HectorJardines/micromouse/README.md

# micromouse
IEEE MicroMouse competition mouse
