HectorJardines/micromouse/bare_mouse/bloo.kicad_pcb

## KiCad design bare_mouse/bloo.kicad_pcb (2025-11-26, last stored version)

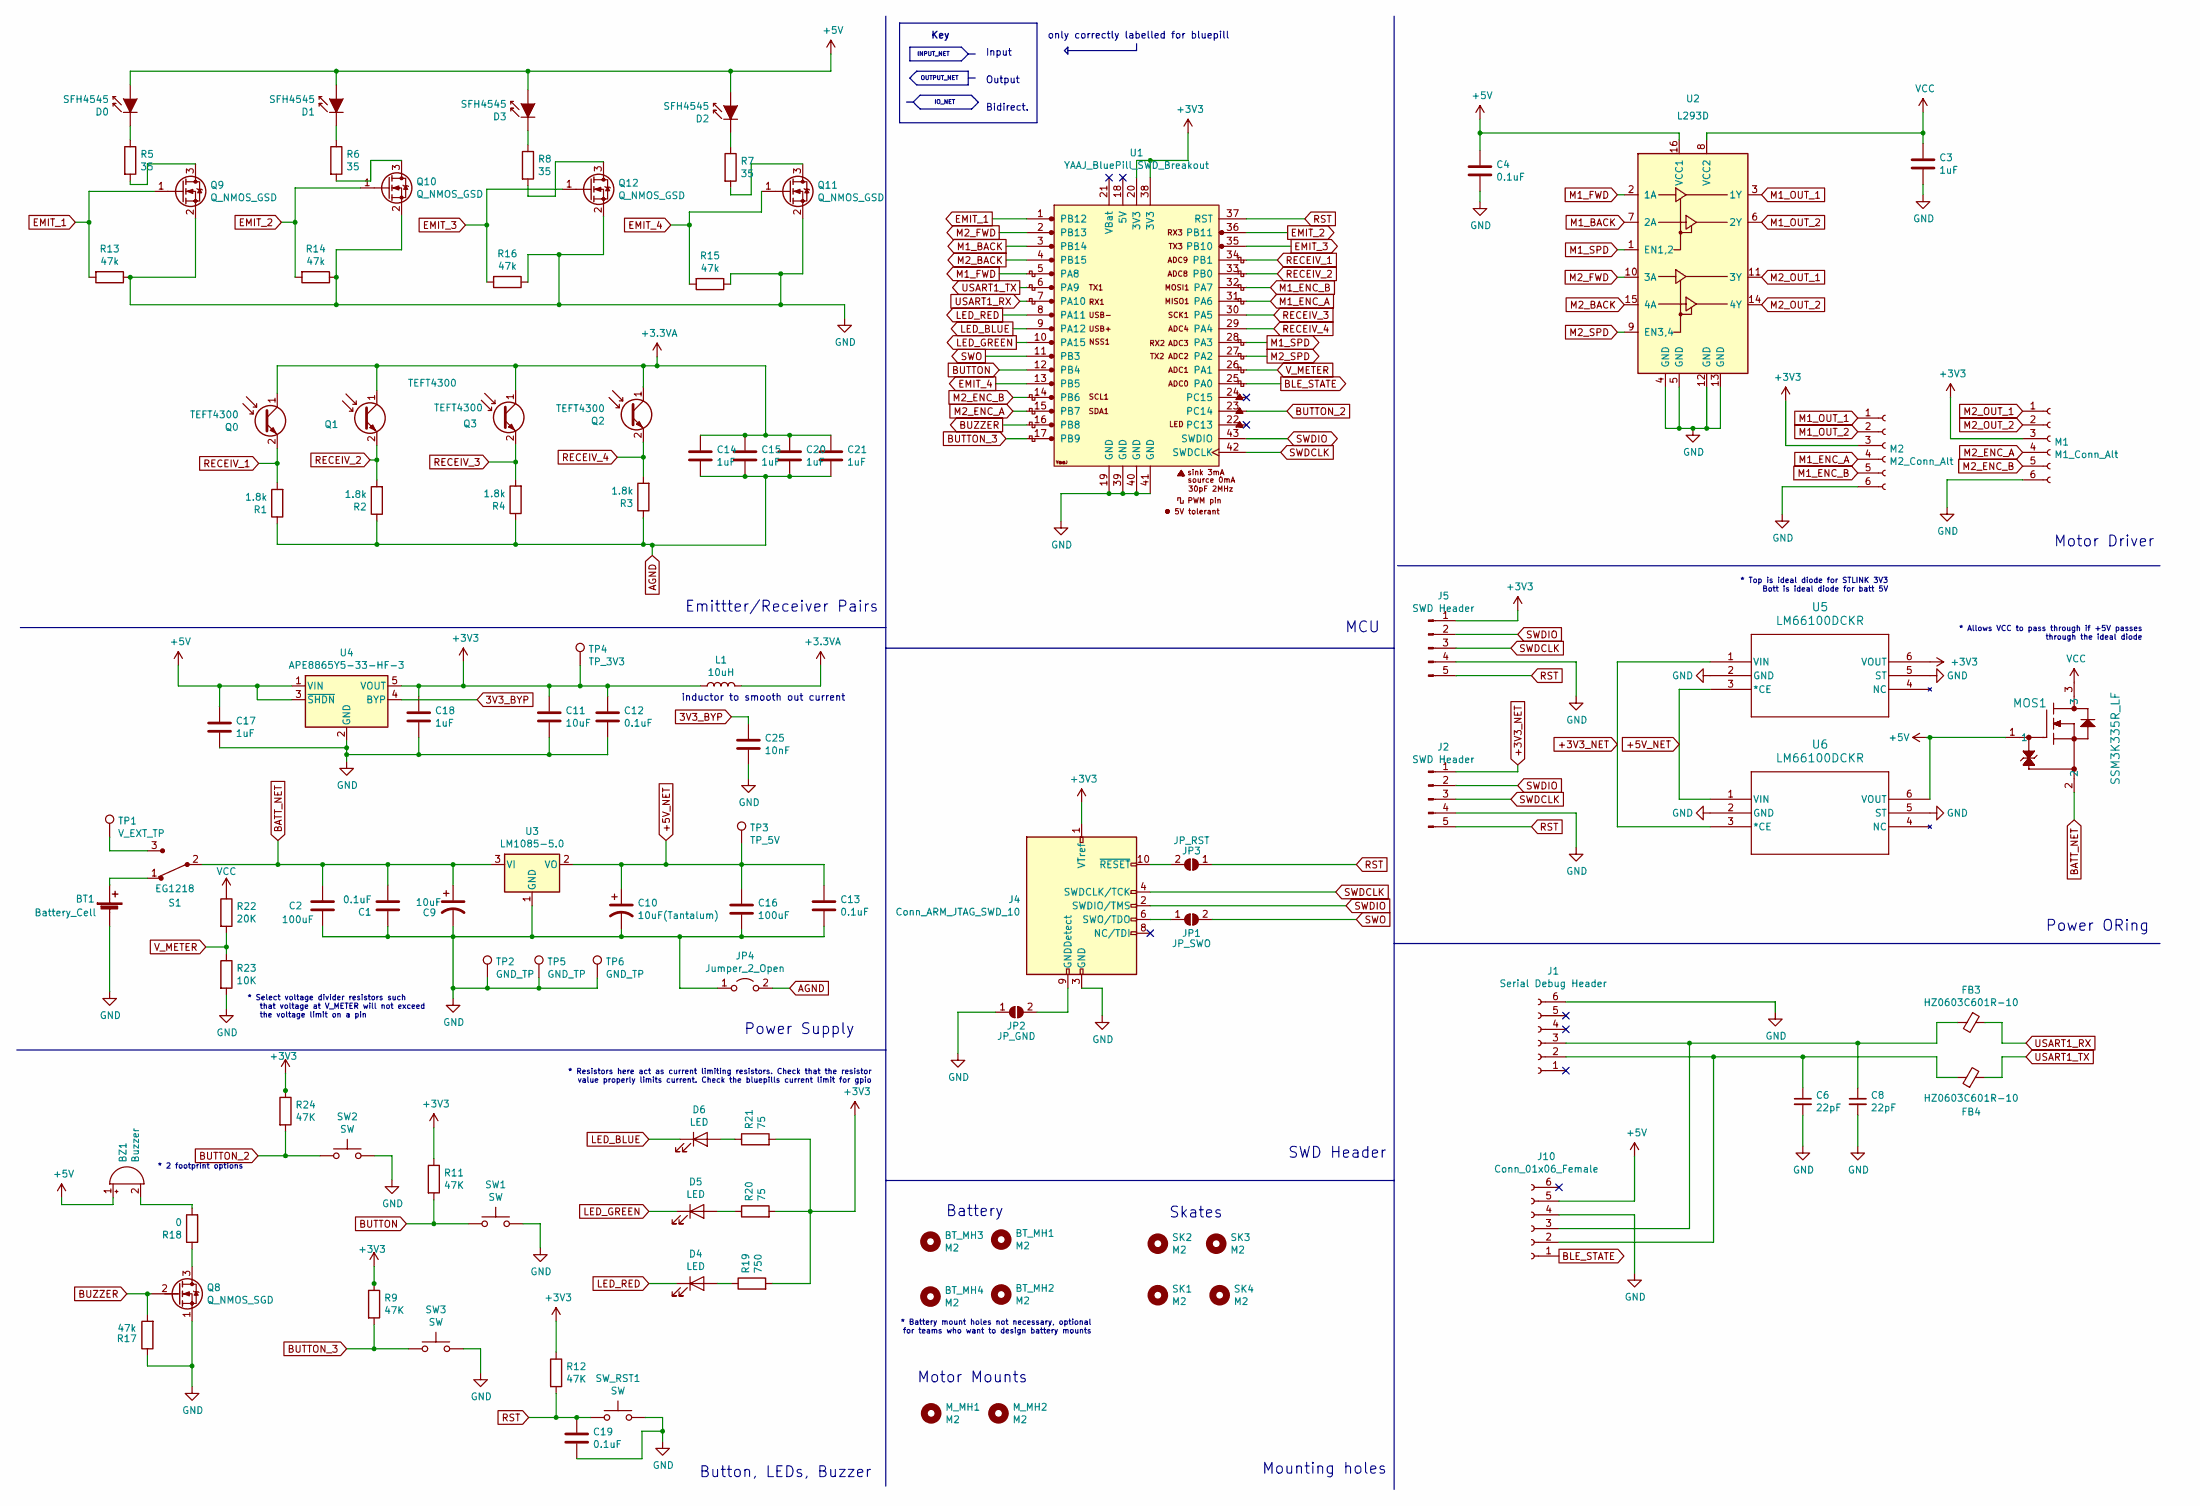
[picture p1: schematic bloo.kicad_sch]

Parts:
BT1: Battery_Cell; PinSocket_1x02_P2.54mm_Vertical
BT_MH1, BT_MH2, BT_MH3, BT_MH4: M2; MountingHole_2.2mm_M2
BZ1: Buzzer; MagneticBuzzer_PUI_AT-0927-TT-6-R
C1, C4, C12, C13, C19: 0.1uF; C_1206_3216Metric_Pad1.33x1.80mm_HandSolder
C2, C16: 100uF; CP_Radial_D6.3mm_P2.50mm
C3, C14, C15, C17, C18, C20, C21: 1uF; C_1206_3216Metric_Pad1.33x1.80mm_HandSolder
C6, C8: 22pF; C_0603_1608Metric_Pad1.08x0.95mm_HandSolder
C9, C11: 10uF; C_1206_3216Metric_Pad1.33x1.80mm_HandSolder
C10: 10uF(Tantalum); C_1206_3216Metric_Pad1.33x1.80mm_HandSolder
C25: 10nF; C_1206_3216Metric_Pad1.33x1.80mm_HandSolder
D0, D1, D2, D3: SFH4545; Emitter
D4, D5, D6: LED; LED_0805_2012Metric_Pad1.15x1.40mm_HandSolder
FB3, FB4: HZ0603C601R-10; R_0603_1608Metric_Pad0.98x0.95mm_HandSolder
J1: Serial Debug Header; PinHeader_1x06_P2.54mm_Vertical
J2, J5: SWD Header; PinHeader_1x05_P2.54mm_Vertical
J4: Conn_ARM_JTAG_SWD_10; PinHeader_2x05_P1.27mm_Vertical
J10: Conn_01x06_Female; PinSocket_1x06_P2.54mm_Vertical
JP1: JP_SWO; SolderJumper-2_P1.3mm_Open_Pad1.0x1.5mm
JP2: JP_GND; SolderJumper-2_P1.3mm_Open_Pad1.0x1.5mm
JP3: JP_RST; SolderJumper-2_P1.3mm_Open_Pad1.0x1.5mm
JP4: Jumper_2_Open; SolderJumper-2_P1.3mm_Bridged_Pad1.0x1.5mm
L1: 10uH; L_1206_3216Metric_Pad1.42x1.75mm_HandSolder
M1: M1_Conn_Alt; Motor Headers
M2: M2_Conn_Alt; Motor Headers
MOS1: SSM3K335R_LF; SOT-23F_TOS
M_MH1, M_MH2: M2; Motor_mouse
Q0, Q1, Q2, Q3: TEFT4300; Emitter
Q8: Q_NMOS_SGD; SOT-23
Q9, Q10, Q11, Q12: Q_NMOS_GSD; SOT-23
R1, R2, R3, R4: 1.8k; R_1206_3216Metric_Pad1.30x1.75mm_HandSolder
R5, R6, R7, R8: 35; R_1206_3216Metric_Pad1.30x1.75mm_HandSolder
R9, R11, R12, R24: 47K; R_1206_3216Metric_Pad1.30x1.75mm_HandSolder
R13, R14, R15, R16, R17: 47k; R_1206_3216Metric_Pad1.30x1.75mm_HandSolder
R18: 0; R_1206_3216Metric_Pad1.30x1.75mm_HandSolder
R19: 750; R_1206_3216Metric_Pad1.30x1.75mm_HandSolder
R20, R21: 75; R_1206_3216Metric_Pad1.30x1.75mm_HandSolder
R22: 20K; R_1206_3216Metric_Pad1.30x1.75mm_HandSolder
R23: 10K; R_1206_3216Metric_Pad1.30x1.75mm_HandSolder
S1: EG1218; MM Switch; MPN EG1218; Digi-Key_PN EG1903-ND
SK1, SK2, SK3, SK4: M2; MountingHole_2.2mm_M2
SW1, SW2, SW3: SW; SW_SPST_REED_CT05-XXXX-G1
SW_RST1: SW; SW_SPST_REED_CT05-XXXX-G1
TP1: V_EXT_TP; PinHeader_1x01_P2.54mm_Vertical
TP2, TP5, TP6: GND_TP; PinHeader_1x01_P2.54mm_Vertical
TP3: TP_5V; PinHeader_1x01_P2.54mm_Vertical
TP4: TP_3V3; PinHeader_1x01_P2.54mm_Vertical
U1: YAAJ_BluePill_SWD_Breakout; STM32F103
U2: L293D; DIP-16_W7.62mm
U3: LM1085-5.0; 5V Voltage Reg
U4: APE8865Y5-33-HF-3; SOT-23-5
U5, U6: LM66100DCKR; DCK6_TEX

Connections:
3V3_BYP: C25.1, U4.4 (BYP)
+3.3VA: C14.1, C15.1, C20.1, C21.1, L1.2, Q0.1 (C), Q1.1 (C), Q2.1 (C), Q3.1 (C)
+3V3: C11.1, C12.1, C18.1, J4.1 (VTref), J5.1, L1.1, M1.3, M2.3, R9.1, R11.1, R12.1, R19.2, R20.2, R21.2, R24.1, TP4.1, U1.20 (3V3), U1.38 (3V3), U4.5 (VOUT), U5.6 (VOUT)
+3V3_NET: J2.1, U5.1 (VIN), U6.3 (*CE)
+5V: BZ1.1 (-), C4.1, C17.1, D0.2 (A), D1.2 (A), D2.2 (A), D3.2 (A), J10.5, MOS1.1, U2.16 (VCC1), U4.1 (VIN), U4.3 (~SHDN), U6.6 (VOUT)
+5V_NET: C10.1, C13.1, C16.1, TP3.1, U3.2 (VO), U5.3 (*CE), U6.1 (VIN)
AGND: C14.2, C15.2, C20.2, C21.2, JP4.2 (B), R1.1, R2.1, R3.1, R4.1
BATT_NET: C1.2, C2.1, C9.1, MOS1.2, S1.2, U3.3 (VI)
BLE_STATE: J10.1, U1.25 (PA0)
BUTTON: R11.2, SW1.1, U1.12 (PB4)
BUTTON_2: R24.2, SW2.1, U1.23 (PC14)
BUTTON_3: R9.2, SW3.1, U1.17 (PB9)
BUZZER: Q8.2 (G), R17.2, U1.16 (PB8)
EMIT_1: Q9.1 (G), R13.2, U1.1 (PB12)
EMIT_2: Q10.1 (G), R14.2, U1.36 (PB11)
EMIT_3: Q12.1 (G), R16.2, U1.35 (PB10)
EMIT_4: Q11.1 (G), R15.2, U1.13 (PB5)
GND: BT1.2 (-), C1.1, C2.2, C3.2, C4.2, C6.2, C8.2, C9.2, C10.2, C11.2, C12.2, C13.2, C16.2, C17.2, C18.2, C19.2, C25.2, J1.6, J2.4, J4.3 (GND), J4.5 (GND), J5.4, J10.4, JP2.1 (A), JP4.1 (A), M1.6, M2.6, Q8.1 (S), Q9.2 (S), Q10.2 (S), Q11.2 (S), Q12.2 (S), R13.1, R14.1, R15.1, R16.1, R17.1, R23.2, SW1.2, SW2.2, SW3.2, SW_RST1.2, TP2.1, TP5.1, TP6.1, U1.19 (GND), U1.39 (GND), U1.40 (GND), U1.41 (GND), U2.4 (GND), U2.5 (GND), U2.12 (GND), U2.13 (GND), U3.1 (GND), U4.2 (GND), U5.2 (GND), U5.5 (ST), U6.2 (GND), U6.5 (ST)
LED_BLUE: D6.1 (K), U1.9 (PA12)
LED_GREEN: D5.1 (K), U1.10 (PA15)
LED_RED: D4.1 (K), U1.8 (PA11)
M1_BACK: U1.3 (PB14), U2.7 (2A)
M1_ENC_A: M2.4, U1.31 (PA6)
M1_ENC_B: M2.5, U1.32 (PA7)
M1_FWD: U1.5 (PA8), U2.2 (1A)
M1_OUT_1: M2.1, U2.3 (1Y)
M1_OUT_2: M2.2, U2.6 (2Y)
M1_SPD: U1.28 (PA3), U2.1 (EN1,2)
M2_BACK: U1.4 (PB15), U2.15 (4A)
M2_ENC_A: M1.4, U1.15 (PB7)
M2_ENC_B: M1.5, U1.14 (PB6)
M2_FWD: U1.2 (PB13), U2.10 (3A)
M2_OUT_1: M1.1, U2.11 (3Y)
M2_OUT_2: M1.2, U2.14 (4Y)
M2_SPD: U1.27 (PA2), U2.9 (EN3,4)
unnamed: BT1.1 (+), S1.1
unnamed: BZ1.2 (+), R18.2
unnamed: D0.1 (K), R5.1
unnamed: D1.1 (K), R6.1
unnamed: D2.1 (K), R7.1
unnamed: D3.1 (K), R8.1
unnamed: D4.2 (A), R19.1
unnamed: D5.2 (A), R20.1
unnamed: D6.2 (A), R21.1
unnamed: C6.1, FB4.1, J1.2, J10.2
unnamed: C8.1, FB3.2, J1.3, J10.3
unnamed: J4.9 (GNDDetect), JP2.2 (B)
unnamed: J4.6 (SWO/TDO), JP1.1 (A)
unnamed: J4.10 (~RESET), JP3.2 (B)
unnamed: Q8.3 (D), R18.1
unnamed: Q9.3 (D), R5.2
unnamed: Q10.3 (D), R6.2
unnamed: Q11.3 (D), R7.2
unnamed: Q12.3 (D), R8.2
unnamed: S1.3, TP1.1
RECEIV_1: Q0.2 (E), R1.2, U1.34 (PB1)
RECEIV_2: Q1.2 (E), R2.2, U1.33 (PB0)
RECEIV_3: Q3.2 (E), R4.2, U1.30 (PA5)
RECEIV_4: Q2.2 (E), R3.2, U1.29 (PA4)
RST: C19.1, J2.5, J5.5, JP3.1 (A), R12.2, SW_RST1.1, U1.37 (RST)
SWDCLK: J2.3, J4.4 (SWDCLK/TCK), J5.3, U1.42 (SWDCLK)
SWDIO: J2.2, J4.2 (SWDIO/TMS), J5.2, U1.43 (SWDIO)
SWO: JP1.2 (B), U1.11 (PB3)
USART1_RX: FB3.1, U1.7 (PA10)
USART1_TX: FB4.2, U1.6 (PA9)
VCC: C3.1, MOS1.3, R22.1, U2.8 (VCC2)
V_METER: R22.2, R23.1, U1.26 (PA1)

Notes on the sheet:
Mounting holes
Output
IO_NET
Power ORing
Battery
Input
inductor to smooth out current
* 2 footprint options
* Battery mount holes not necessary, optional for teams who want to design battery mounts
* Top is ideal diode for STLINK 3V3 Bott is ideal diode for batt 5V
Motor Driver
* Allows VCC to pass through if +5V passes through the ideal diode
Emittter/Receiver Pairs
* Resistors here act as current limiting resistors. Check that the resistor value properly limits current. Check the bluepills current limit for gpio
Bidirect.
MCU
OUTPUT_NET
SWD Header
only correctly labelled for bluepill
* Select voltage divider resistors such that voltage at V_METER will not exceed the voltage limit on a pin
Motor Mounts
Button, LEDs, Buzzer
Skates
Power Supply
Key
INPUT_NET

Board: 2 copper layers, 103 parts (0 on the bottom side), 67 nets, no tracks yet.
