HectorJardines/micromouse/Core/Inc/drivers/io.h

#ifndef _IO_H
#define _IO_H

#include "../../Drivers/STM32F1xx_HAL_Driver/Inc/stm32f1xx_hal.h"
#include <stdint.h>
#include <stdbool.h>

#define ENABLE  (0x1U)
#define DISABLE (0x0U)
#define SET     (ENABLE)
#define RESET   (DISABLE)

/**********************************
*          USER IO ENUMS
***********************************/
typedef enum 
{
    IO_PORTA_NUM,
    IO_PORTB_NUM,
    IO_PORTC_NUM
} io_port_num_e;

typedef enum
{
    IO_PIN_0,
    IO_PIN_1,
    IO_PIN_2,
    IO_PIN_3,
    IO_PIN_4,
    IO_PIN_5,
    IO_PIN_6,
    IO_PIN_7,
    IO_PIN_8,
    IO_PIN_9,
    IO_PIN_10,
    IO_PIN_11,
    IO_PIN_12,
    IO_PIN_13,
    IO_PIN_14,
    IO_PIN_15
} io_pin_no_e;

typedef enum
{
    // PORT A
    IO_A0, IO_A1, IO_A2, IO_A3,
    IO_A4, IO_A5, IO_A6, IO_A7,
    IO_A8, IO_A9, IO_A10, IO_A11,
    IO_A12, IO_A13, IO_A14, IO_A15,

    // PORT B
    IO_B0, IO_B1, IO_B2, IO_B3,
    IO_B4, IO_B5, IO_B6, IO_B7,
    IO_B8, IO_B9, IO_B10, IO_B11,
    IO_B12, IO_B13, IO_B14, IO_B15,

    // PORT C
    IO_C0, IO_C1, IO_C2, IO_C3,
    IO_C4, IO_C5, IO_C6, IO_C7,
    IO_C8, IO_C9, IO_C10, IO_C11,
    IO_C12, IO_C13, IO_C14, IO_C15
} generic_io_e;

typedef enum
{
    // PORT A PINS
    IO_UNUSED_0 = IO_A0,
    BMI160_INT_CH1 = IO_A1,
    IO_M1_PWM = IO_A2,
    IO_M2_PWM = IO_A3,
    IO_IR_RECEIVE_4 = IO_A4,
    IO_IR_RECEIVE_3 = IO_A5,
    M1_ENC_A = IO_A6,
    M1_ENC_B = IO_A7,
    M1_DRIVER_IN1 = IO_A8,

    // TODO: VERIFY THAT WE WONT NEED THESE FOR I2C/SPI COMMS
    IO_IR_EMIT_4 = IO_A9,
    IO_IR_EMIT_3 = IO_A10,
    IO_IR_EMIT_2 = IO_A11,
    IO_IR_EMIT_1 = IO_A12,

    IO_RESERVED_13 = IO_A13,
    IO_RESERVED_14 = IO_A14,
    IO_UNUSED_15 = IO_A15,

    // PORT B PINS
    IO_IR_RECEIVE_2 = IO_B0,
    IO_IR_RECEIVE_1 = IO_B1,
    M2_DRIVER_IN1 = IO_B2, // USE FOR M2_DRIVER_IN1
    IO_UNUSED_19 = IO_B3,
    M1_DRIVER_IN2 = IO_B4, // USE FOR M1_DRIVER_IN2
    M2_DRIVER_IN2 = IO_B5,
    I2C1_SCL = IO_B6, // REMAP TO B8, use this for I2C1_SCL
    I2C1_SDA = IO_B7, // REMAP TO B9, use this for I2C1_SDA

    M2_ENC_B = IO_B8, // USE FOR TIM4_CH3
    M2_ENC_A = IO_B9, // USE FOR TIM4_CH4
    IO_USART3_TX = IO_B10,
    IO_USART3_RX = IO_B11,
    SPI2_NSS = IO_B12,
    SPI2_SCK = IO_B13,
    SPI2_MISO = IO_B14,
    SPI2_MOSI = IO_B15,

    // PORT C PINS
    IO_RESERVED_32 = IO_C0,
    IO_RESERVED_33 = IO_C1,
    IO_RESERVED_34 = IO_C2,
    IO_RESERVED_35 = IO_C3,
    IO_RESERVED_36 = IO_C4,
    IO_RESERVED_37 = IO_C5,
    IO_RESERVED_38 = IO_C6,
    IO_RESERVED_39 = IO_C7,
    IO_RESERVED_40 = IO_C8,
    IO_RESERVED_41 = IO_C9,
    IO_RESERVED_42 = IO_C10,
    IO_RESERVED_43 = IO_C11,
    IO_RESERVED_44 = IO_C12,
    IO_LED_RED = IO_C13,
    IO_LED_BLUE = IO_C14,
    IO_LED_GREEN = IO_C15
} io_e;

typedef enum
{
    io_mode_input,
    io_mode_output_10MHz,
    io_mode_output_2MHz,
    io_mode_output_50MHz,
    io_mode_reserved
} io_mode_e;

typedef enum
{
    io_cnf_input_analog,
    io_cnf_input_float,
    io_cnf_input_pupd
} io_cnf_input_e;

typedef enum
{
    io_cnf_output_gpio_pp,
    io_cnf_output_gpio_od,
    io_cnf_output_af_pp,
    io_cnf_output_af_od,
    io_cnf_reserved
} io_cnf_output_e;

typedef enum
{
    exti_no_0,
    exti_no_1,
    exti_no_2,
    exti_no_3,
    exti_no_4,
    exti_no_5,
    exit_no_6,
    exti_no_7,
    exti_no_8,
    exit_no_9,
    exti_no_10,
    exti_no_11,
    exit_no_12,
    exti_no_13,
    exti_no_14,
    exti_no_15
} exti_no_e;

typedef enum
{
    io_it_ft,
    io_it_rt,
    io_it_ft_rt
} io_it_trigger_e;

typedef enum 
{
    LOW,
    HIGH
} io_out_e;

/**********************************
*          USER IO Structs
***********************************/
typedef struct
{
    uint8_t mode;           /* Specifies Mode: Input (default) OR Output [10/2/50MHz] */
    uint8_t mode_config;    /* Specifies Mode Config: Input (analog, floating input, push-pull) OR Output (GPIO PP/OD : AF PP/OD) */

} io_config_t;

/**********************************
*          USER IO APIs
***********************************/
/**
 * @brief sets the output for the specified io pin
 */
void io_set_out(io_e io, io_out_e out);

/**
 * @brief toggles the output for the speecified io pin
 */
void io_toggle_out(io_e io);

/**
*   io_configure - Sets the configuration of all the pins used/unused
*   
*
*   @return void
**/
void io_configure(void);

/**
*   io_init - inits a singles io pin with the specified configuration struct
*   
*   @param io_config - io pin configuration struct, specifies mode/speed, resistance, etc.
*   @return void
**/
void io_init(io_e io, const io_config_t *io_config);

/**
 *  io_get_configuration -  retrieves the actual configuration of the initialized
 *                          pin and stores the configuration into a struct
 * 
 *  @param io - io pin to retrieve configuration of
 *  @return io_config_t
 */
void io_get_configuration(io_e io, io_config_t *actual);

/**
 *  io_verify_config -  compares configured io pin with config struct
 * 
 *  @param curr_cnf - io pin to check configuration of
 *  @param expected_cnf - expected io configuration
 *  @return void
 */
bool io_verify_config(io_config_t *curr_cnf, io_config_t *expected_cnf);


void io_set_out(io_e, io_out_e);

#endif
