HectorJardines/micromouse/Core/tests/test_hardware.c

#include "../inc/common/assert_handler.h"
#include "../inc/drivers/io.h"
#include "../inc/drivers/uart.h"
#include "../inc/main.h"
#include "../external/printf/printf.h"
#include "../Inc/drivers/encoder.h"
#include "../Inc/common/log.h"
#include "../Inc/drivers/pid.h"
#include "../Inc/drivers/pwm.h"
#include "../Inc/drivers/imu_interface.h"
#include "../Inc/drivers/ssd1306.h"
#include "../Inc/drivers/ir_interface.h"

void test_setup(void) {
    SystemClock_Config();
    // HAL_MspInit();
    io_configure();
    log_init();
    log_set_level(LOG_LEVEL_DEBUG);
}

void test_uart(void) {
    usart_init();
    char msg[7] = "Hello\n";
    while(1) {
        usart_write(msg, 6);
    }
}

void test_putchar(void) {
    usart_init();

    while(1) {
        _putchar('H');
        _putchar('e');
        _putchar('l');
        _putchar('l');
        _putchar('o');
        _putchar('\n');
    }
}

void test_assert(void) {
    ASSERT(0, ASSERT_DRIVER_LEVEL);
}

void test_log(void) {
    // log_init();

    while(1) {
        LOG(LOG_LEVEL_DEBUG, "HELLO IM GAY...\n");
    }
}

void test_encoder(void) {
    // log_init();
    encoder_init();

    uint16_t left_count = 0;
    uint16_t right_count = 0;

    while (1) {
        left_count = encoder_read_left_count();
        right_count = encoder_read_right_count();

        LOG(LOG_LEVEL_DEBUG, "ENCODER COUNT RIGHT = %d\n", right_count);
        LOG(LOG_LEVEL_DEBUG, "ENCODER COUNT LEFT = %d\n", left_count);

        HAL_Delay(500);
    }
}

void test_pwm(void) {
    pwm_init();
    // io_set_out(IO_UNUSED_24, HIGH);
    io_set_out(M1_DRIVER_IN1, HIGH);
    io_set_out(M1_DRIVER_IN2, LOW);

    io_set_out(M2_DRIVER_IN1, HIGH);
    io_set_out(M2_DRIVER_IN2, LOW);

    while (1) {
        pwm_set_duty_cycle(PWM_TB6612FNG_LEFT, 30);
        pwm_set_duty_cycle(PWM_TB6612FNG_RIGHT, 50);
        HAL_Delay(100);

        pwm_set_duty_cycle(PWM_TB6612FNG_LEFT, 45);
        pwm_set_duty_cycle(PWM_TB6612FNG_RIGHT, 45);
        HAL_Delay(100);

        pwm_set_duty_cycle(PWM_TB6612FNG_LEFT, 60);
        pwm_set_duty_cycle(PWM_TB6612FNG_RIGHT, 60);
        HAL_Delay(100);

        pwm_set_duty_cycle(PWM_TB6612FNG_LEFT, 75);
        pwm_set_duty_cycle(PWM_TB6612FNG_RIGHT, 75);
        HAL_Delay(100);
    }
}

void test_pid(void) {
    pid_init();
    
    // set GOAL to 18cm away
    set_pid_goal_dist(PID_DIST_TO_ENC_COUNT(18));
    while(1) {
        pid_update();
        // HAL_Delay(1);
        if (pid_done()) {
            // reset_pid();
            // set_pid_goal_dist(PID_DIST_TO_ENC_COUNT(18));
            LOG(LOG_LEVEL_DEBUG, "TRAVELED 18 CM...\n");

            break;
        }
    }

    while(1) {
        
        HAL_Delay(100);
        io_toggle_out(IO_LED_RED);
        HAL_Delay(100);
        io_toggle_out(IO_LED_BLUE);
        HAL_Delay(100);
        io_toggle_out(IO_LED_GREEN);

    }
}

void test_imu_self_test(void) {
    imu_init();

    while(1) {
        int8_t res = imu_self_test_accel();
        // if (!res)
            // LOG("IMU ACCEL SELF TEST PASS...\n");
        res = imu_self_test_gyro();
        // if (!res)
            // LOG("IMU GYRO SELF TEST PASS...\n");
        
        if (res) {
            while(1) {
                HAL_Delay(100);
                io_toggle_out(IO_LED_RED);
            }   
        }
        
        while(1) {
            HAL_Delay(100);
            io_toggle_out(IO_LED_RED);
            HAL_Delay(100);
            io_toggle_out(IO_LED_BLUE);
            HAL_Delay(100);
            io_toggle_out(IO_LED_GREEN);
        }
    }
}

void test_imu_read_accel_values(void) {
    imu_init();

    struct bmi160_sensor_data accel;
    struct bmi160_sensor_data gyro;

    while (1) {
        int8_t res = imu_read_sensor_data(&accel, &gyro);
        if (res) {
            LOG(LOG_LEVEL_DEBUG, "ERRO RETRIEVING DATA...\n");
            while(1) {
                HAL_Delay(100);
                io_toggle_out(IO_LED_RED);
            } 
        }

        LOG(LOG_LEVEL_DEBUG, "ACCEL - X: %d, Y: %d, Z: %d\n", accel.x, accel.y, accel.z);
        LOG(LOG_LEVEL_DEBUG, "GYRO - X: %d, Y: %d, Z: %d\n", gyro.x, gyro.y, gyro.z);
        HAL_Delay(500);
    }
}

void test_imu_read_left_right_drift(void) {
    imu_init();
    float angle_z = 0;

    while (1) {
        
        int8_t res = imu_get_angle_z(&angle_z, .01);
        if (res) {
            LOG(LOG_LEVEL_DEBUG, "ERRO RETRIEVING PITCH/ROLL...\n");
            while(1) {
                HAL_Delay(100);
                io_toggle_out(IO_LED_RED);
            } 
        }

        LOG(LOG_LEVEL_DEBUG, "ANGLE Z: %f degrees\n", angle_z);

        HAL_Delay(10);
    }
}

void test_pid_with_angle_correction(void) {
    pid_init();

    set_pid_goal_dist(PID_DIST_TO_ENC_COUNT(100));
    // set_pid_goal_angle(PID_ANGLE_TO_ENC_COUNT(0));
    while(1) {
        pid_update();
        // HAL_Delay(1);
        if (pid_done()) {
            // reset_pid();
            // set_pid_goal_dist(PID_DIST_TO_ENC_COUNT(18));
            LOG(LOG_LEVEL_DEBUG, "TRAVELED 100 CM...\n");

            break;
        }
    }

    while(1) {
        
        HAL_Delay(100);
        io_toggle_out(IO_LED_RED);
        HAL_Delay(100);
        io_toggle_out(IO_LED_BLUE);
        HAL_Delay(100);
        io_toggle_out(IO_LED_GREEN);

    }
}

void test_oled_control(void) {
    ssd1306_init();
    //id: 0 pixel 3 
    ssd1306_draw_pixel(14, 9, COLOR_WHITE);
    ssd1306_draw_pixel(14, 10, COLOR_WHITE);
    ssd1306_draw_pixel(14, 11, COLOR_WHITE);
    ssd1306_draw_pixel(14, 12, COLOR_WHITE);
    ssd1306_draw_pixel(14, 13, COLOR_WHITE);
    ssd1306_draw_pixel(14, 14, COLOR_WHITE);
    ssd1306_draw_pixel(14, 15, COLOR_WHITE);
    ssd1306_draw_pixel(14, 16, COLOR_WHITE);
    ssd1306_draw_pixel(14, 17, COLOR_WHITE);
    ssd1306_draw_pixel(14, 18, COLOR_WHITE);
    ssd1306_draw_pixel(14, 19, COLOR_WHITE);
    ssd1306_draw_pixel(14, 20, COLOR_WHITE);
    ssd1306_draw_pixel(14, 21, COLOR_WHITE);
    ssd1306_draw_pixel(14, 22, COLOR_WHITE);
    ssd1306_draw_pixel(14, 23, COLOR_WHITE);
    ssd1306_draw_pixel(14, 24, COLOR_WHITE);
    ssd1306_draw_pixel(14, 25, COLOR_WHITE);
    ssd1306_draw_pixel(14, 26, COLOR_WHITE);
    ssd1306_draw_pixel(14, 27, COLOR_WHITE);
    ssd1306_draw_pixel(14, 28, COLOR_WHITE);
    ssd1306_draw_pixel(14, 29, COLOR_WHITE);
    ssd1306_draw_pixel(14, 30, COLOR_WHITE);
    ssd1306_draw_pixel(14, 31, COLOR_WHITE);
    ssd1306_draw_pixel(14, 32, COLOR_WHITE);
    ssd1306_draw_pixel(14, 33, COLOR_WHITE);
    ssd1306_draw_pixel(14, 34, COLOR_WHITE);
    ssd1306_draw_pixel(14, 35, COLOR_WHITE);
    ssd1306_draw_pixel(14, 36, COLOR_WHITE);
    ssd1306_draw_pixel(14, 37, COLOR_WHITE);
    ssd1306_draw_pixel(14, 38, COLOR_WHITE);
    ssd1306_draw_pixel(14, 39, COLOR_WHITE);
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
    ssd1306_draw_pixel(109, 35, COLOR_WHITE);
    ssd1306_draw_pixel(110, 35, COLOR_WHITE);
    ssd1306_draw_pixel(111, 35, COLOR_WHITE);
    ssd1306_draw_pixel(112, 35, COLOR_WHITE);
    ssd1306_draw_pixel(113, 34, COLOR_WHITE);
    ssd1306_draw_pixel(114, 34, COLOR_WHITE);
    ssd1306_draw_pixel(115, 34, COLOR_WHITE);
    ssd1306_draw_pixel(116, 34, COLOR_WHITE);
    ssd1306_draw_pixel(117, 34, COLOR_WHITE);
    ssd1306_draw_pixel(118, 34, COLOR_WHITE);
    ssd1306_draw_pixel(119, 34, COLOR_WHITE);
    ssd1306_draw_pixel(120, 34, COLOR_WHITE);
    ssd1306_display();
}

static void test_ir_interface(void) {
    ir_init();
    ir_receiver_samples_t samples;
    while (1) {
        ir_start_multi_sample();
        ir_read_all_sensors(&samples);
        LOG(LOG_LEVEL_DEBUG, "RIGHT SENSOR VALUE: %d\n", samples.RIGHT_SAMPLE);
        LOG(LOG_LEVEL_DEBUG, "RIGHT DIAG SENSOR VALUE: %d\n", samples.RIGHT_DIAG_SAMPLE);
        LOG(LOG_LEVEL_DEBUG, "LEFT_DIAG SENSOR VALUE: %d\n", samples.LEFT_DIAG_SAMPLE);
        LOG(LOG_LEVEL_DEBUG, "LEFT SENSOR VALUE: %d\n", samples.LEFT_SAMPLE);
        HAL_Delay(500);
    }
}

int main(void) {
    test_setup();
    test_ir_interface();
}
