HectorJardines/micromouse/(commit log)

2025-10-30 [io.c/io.h] Include basic IO driver
    IO driver functionality includes io pin configuration structures and enums as well as IO configuration APIs. Pending fixes include: implementing IO interruption configuration and alternate function pin mode configuration.
    [bloo.kicad_pcb, bloo.kicad_sch, bloo.sch]
2025-10-30 [Feature(io.c)] Include IO interrupt configuration
    If included, commit will implement the IO interrupt configurationg APIs. These will be used throughout the project to configure interrupt triggers, set EXTI lines to the appropriate ports, and register the irq_handlers for the interrupt pins.
2025-11-11 [chore] include file structure for different drivers
    [bloo.kicad_pcb]
2025-11-13 [feat(pwm.c)] implement pwm drivers for timer 2 channels1/2
    If included, commit will implement the basic pwm drivers to initialize pwm, enable/disable pwm, and set duty cycles on the timer 2 peripheral.
2025-11-13 [feat(encoder.c)] Implement encoder driver
    If included, commit implements the basic encoder driver that will be used to calculate position and speed/acceleration of our rat. This driver utilizes channels 1 and 2 of timers 3 and 4 in encoder interface mode. The configuration allows us to read 360 encoder counts per revolution.
2025-11-13 [fix(pwm.c)] update pwm timer frequency
    If included, commit corrects and error in the calculation of the pwm timer frequency. The l293d dual h-bridge driver is rated for up to 5KHz frequencies. The timer frequency was previously set for 20KHz
    [pwm.c]
2025-11-13 [chore(l293d.c/pid.c)] Include pid and l293d driver skeleton code
2025-11-19 [feat(l293d.c)] Implement l293d drivers
    If included, commit implements the l293d motor driver user APIs that will be used throughout the project to control motor speed and direction. The driver includes APIs to set direction to forward, reverse, or stop values. Additionally includes an API that allows the user to set speed of the a given motor by specifying a desired pwm duty cycle value.
    [l293d.c]
2025-11-19 [fix(pwm.c)] fix bug that was caused by calling the incorrect pwm function
    [pwm.c, pwm.h]
2025-11-21 [feat(systick.c/encoder.c)] implement basic systick functionality that updates pid values every 1ms
    If included, commit implements the systick driver file that installs and enables a SysTick irq handler that updates the pid control values every ms. The commit includes encoder APIs to set and reset count values. Used in the SysTick handler to keep the encoder counts from rolling over and disrupting the pid control values.
    [encoder.c, encoder.h, systick.c]
2025-11-26 [feat(pid.c)] pd controller skeleton code
    [bloo.kicad_pcb]
2026-03-01 [chore] remove schematic files from repo
    [bloo.kicad_pcb, bloo.kicad_sch, bloo.sch]
2026-03-01 [chore] create new files for logging and gyroscope implementations
2026-03-04 [feature(io.c)] implement io interrupt driver
    commit implements the external IO interrupt handling logic using an array of ISRs registered to each pin.
2026-03-05 [feature(spi.c)] implement spi peripheral driver to interface with BMI160 IMU
    the simple spi peripheral driver implements multi-byte read and write APIs that interface with the BMI 160 IMU. Include peripheral configuration and initialization.
2026-03-26 [chore] include template code
    If included, commit includes the template code for dma, adc, ir_interface, and encoder drivers.
2026-03-31 [chore] re-generate cubemx configuration files
    CubeMX files were originally generated for the STM32F103C8 processor. Commit updates the CubeMX generated files to match the actual processor being used, the STM32F103CBT6. Commit also moves the Inc and Src folders into the Core folder to save me the headache of having to get a working Makefile.
2026-03-31 [feature(uart.c/assert_handler.h)] Implement first iteration of assert handling with logging
    If included, commit implements a simple assert handler that toggles an LED with color corresponding to type of assert alongside a message containing the current PC value. Commit also includes the mpaland printf submodule for a small printf implementation for embedded systems.
2026-04-01 [features(Core/tests)] Include ceedling test framework folder for integratation and unit testing
2026-04-01 [feature(log.c)] Implement basic logging functionality
    If included, commit implements a simple logging interface for printf style debugging. As the system grows in complexity we will implement more complex logging functionality that can be used across submodules for different purposes.
2026-04-04 [fix(uart/assert_handler)] Fix uart peripheral configuration and assert_handler logic
    If included, commit implements a fix in the UART logic that incorrectly configures parity and hardware flow control. The commit also fixes the systick handler definition in pid.c that was interfering with the HAL_Delay functionality that is needed by assert_handler logic. Commit includes a working implementation of UART for logging and assert handling.
    [assert_handler.c, systick.c, test_hardware.c, uart.c, uart.h]
2026-04-04 [fix(io/ring_buffer)] Implement fix for incorrectly configured usart rx pin
    If included, commit implements an update to the USART RX pin configuration. Originally the pin was set to alternate function output mode, the intended mode is input with no pull-up or -down. A small change in ring_buffer.c is included as well that adds an ASSERT that ensures the ring buffer is not empty before popping an element.
    [io.c, io.h, ring_buffer.c]
2026-04-04 [feat(adc/ir_interface)] implement a simple template for adc and ir_interface drivers
    If included, commit implements an adc driver and ir_interface driver used for wall detection. The modules are outlines of some of the necessary functionalities e.g. continuous sampling of ir sensors, single and multiple sample reads, etc. Wall detection is an outline of the module that will be defined once we have a clear idea of the requirements for the module, e.g. how we define walls, how the floodfill module will interact with out wall module, etc.
2026-04-10 [feature(pid/pwm.c)] Implement PID controller module first iteration
    If included, commit implements the first iteration of the PID controller. This modules makes use of the pwm, encoder, and tb6612fng drivers to implement a PD controller that will be used in our drive module. The implementation still requires PD constant tuning.
2026-04-10 [chore] Add bmi160 IMU api as submodule
2026-04-10 [Chore] readd mpaland printf repo as a proper submodule
2026-04-16 [feature(imu_interface.c/pid.c)] implement bmi160 interface for yaw sampling and pid angle correction
    Commit implements the bmi160 inteface module that configures the bmi160 imu via the bmi160 api. BMI160 gyro z axis samples are used for angle correction in the PD controller. Verification of PD controller is difficult without an actual robot. Need to make the robot and then calibrate the constants.
    [imu_interface.c, imu_interface.h, io.c, io.h, pid.c, pid.h, spi.c]
2026-04-21 [feature(ssd1306.c/i2c.c)] implement OLED display driver functionality
    If included, commit implements a simple blocking I2C used in configuration and updating of the 128x64 oled display module. The ssd1306.c module implements configuration APIs that configure the display clock, memory addressing, display layout, etc. Configurations are performed via I2C write transactions. The module also implements pixel drawing and display updating functionalities.
2026-04-23 [feature(log.c)] Implement log level functionality and optional disabling of printf debugging
    If included, commit implements an API that allows for setting the "level" of logging that is performed. E.g. setting log level to ERROR, will only execute log statements that trigger on error conditions. DEBUG, WARNING, etc. will all be ignored. Each log statement must now be prefaced with a log level option.
    [i2c.c, imu_interface.c, log.c, pid.c, pwm.c, uart.c, uart.h]
2026-04-23 [feature(ir_interface.c)] Implement IR receiver/emitter pair interfacing module
    If included, commit implements the IR sensor interface module that allows for sampling of the four different IR receiver/emitter pairs on the mouse. This module will be used in the PID module for correction based on wall detection. Simple hardware validation tests are provided in the test_hardware.c module.
    [adc.c, adc.h, defines.h, dma.c, io.c, ir_interface.c, ir_interface.h, test_hardware.c]
